Roboost-Robotics/roboost/ros2/roboost_bringup/meshes/Chassis.STL

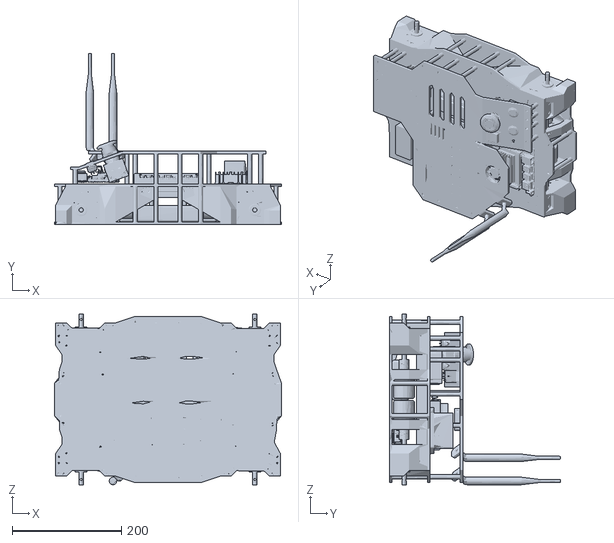
[picture p1: CAD file, 2026-10-19]
ros2/roboost_bringup/meshes/Chassis.STL
416.0 x 314.3 x 313.4
