Roboost-Robotics/roboost/ros2/roboost_bringup/meshes/Mecanum-Wheel-Left.STL

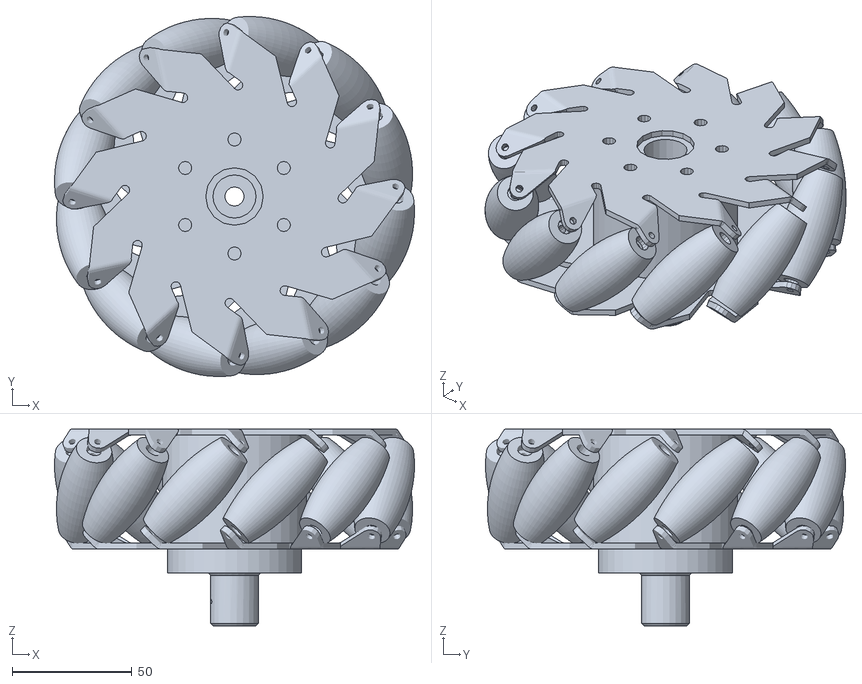
[picture p2: CAD file, 2026-10-19]
ros2/roboost_bringup/meshes/Mecanum-Wheel-Left.STL
150.0 x 150.0 x 82.0
