Roboost-Robotics/roboost/ros2/roboost_bringup/meshes/RP-LiDAR.STL

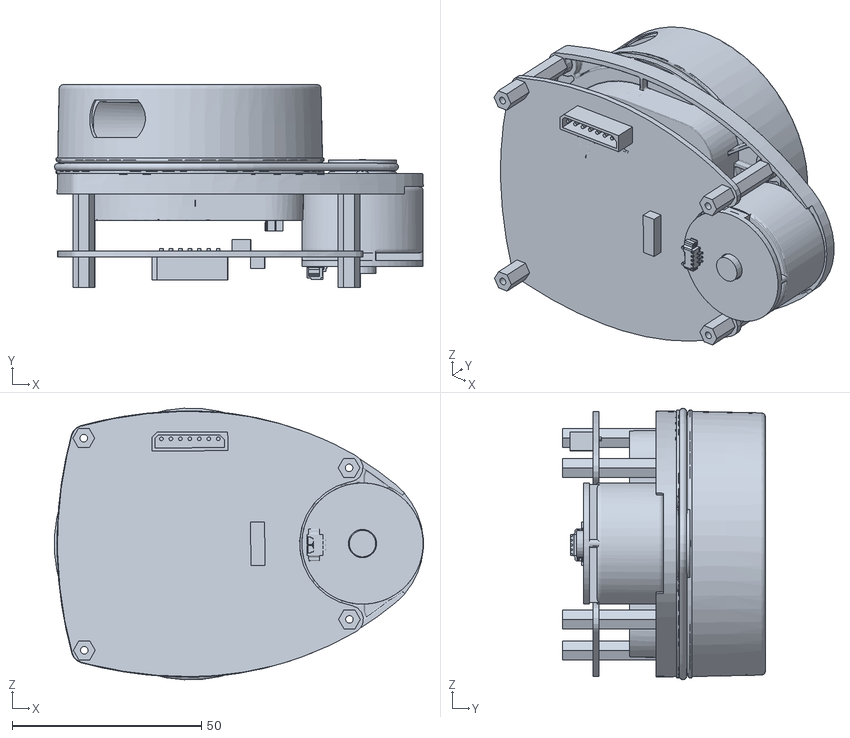
[picture p3: CAD file, 2026-10-19]
ros2/roboost_bringup/meshes/RP-LiDAR.STL
97.4 x 53.5 x 71.7
