Roboost-Robotics/roboost/(list of files, cad)

Other CAD files:
ros2/roboost_bringup/meshes/Mecanum-Wheel-Right.STL
